GitHubLHAn/Phase_Detection_Project/Master_box_26.07.14/Master_Hình ảnh/Master 04.bmp

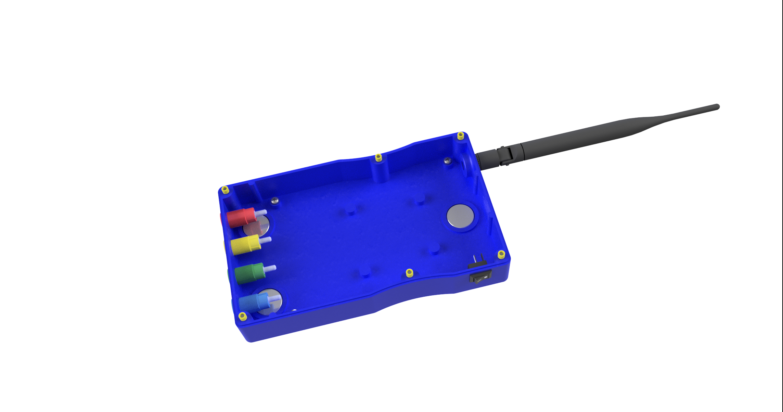
Master_box_26.07.14/Master_Hình ảnh/Master 04.bmp
