GitHubLHAn/Phase_Detection_Project/Master_box_26.07.14/Master_Hình ảnh/Screenshot_1.png

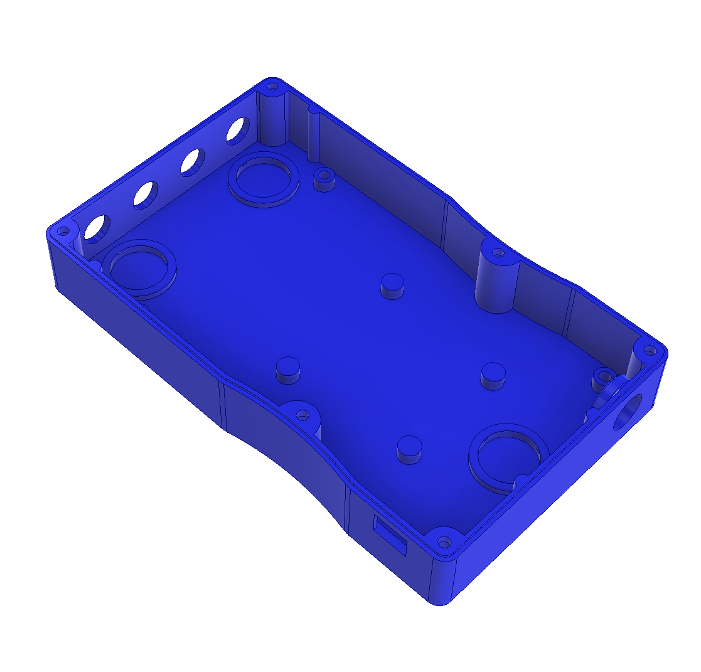
Master_box_26.07.14/Master_Hình ảnh/Screenshot_1.png
