GitHubLHAn/Phase_Detection_Project/master_image.png

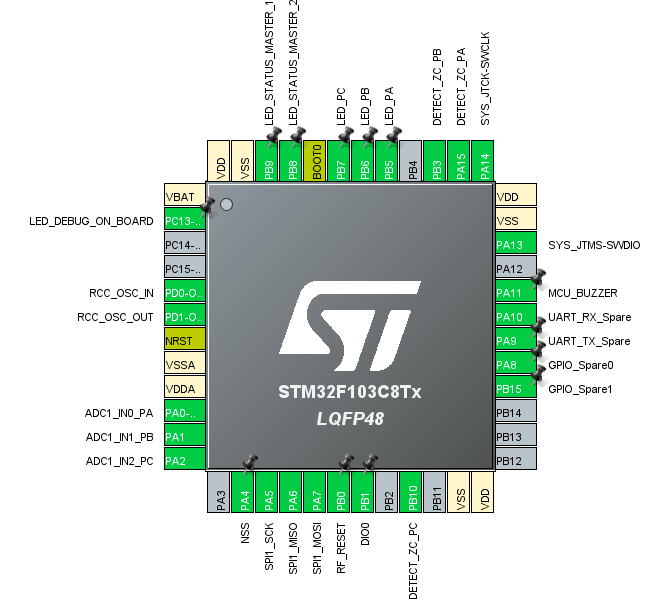
master_image.png
