GitHubLHAn/Phase_Detection_Project/Slave_box_26.07.14/Hình ảnh/Screenshot_6.png

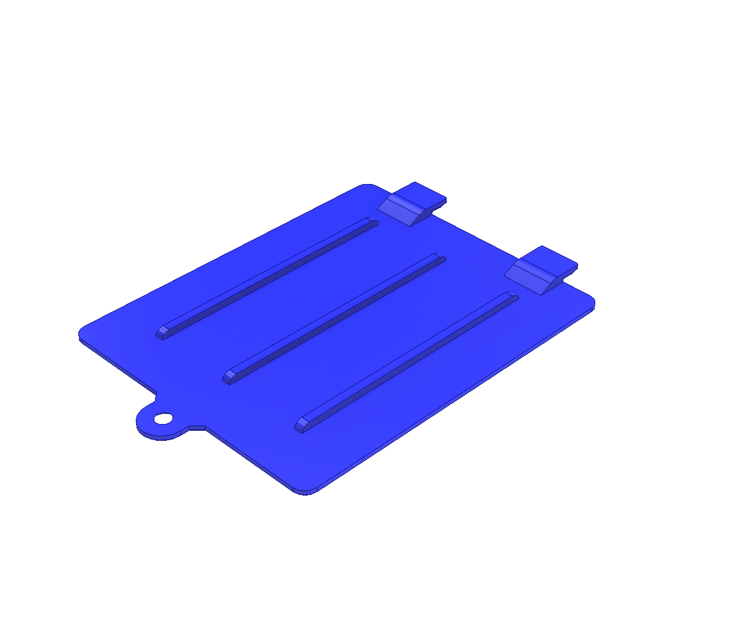
Slave_box_26.07.14/Hình ảnh/Screenshot_6.png
