GitHubLHAn/Phase_Detection_Project/Slave_box_26.07.14/Hình ảnh/Slave-02.bmp

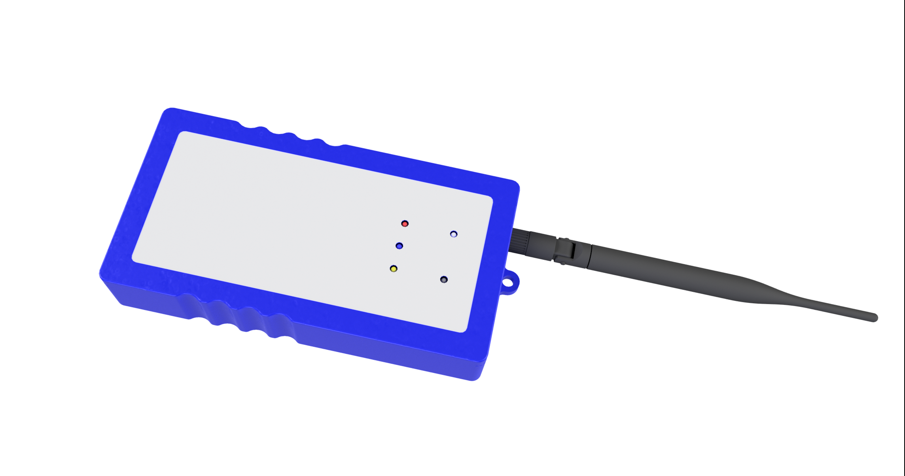
Slave_box_26.07.14/Hình ảnh/Slave-02.bmp
