GitHubLHAn/Phase_Detection_Project/Master_box_26.07.14/3D Step/Nắp Master_SLA_Màu xanh Cô ban_SL01.stp

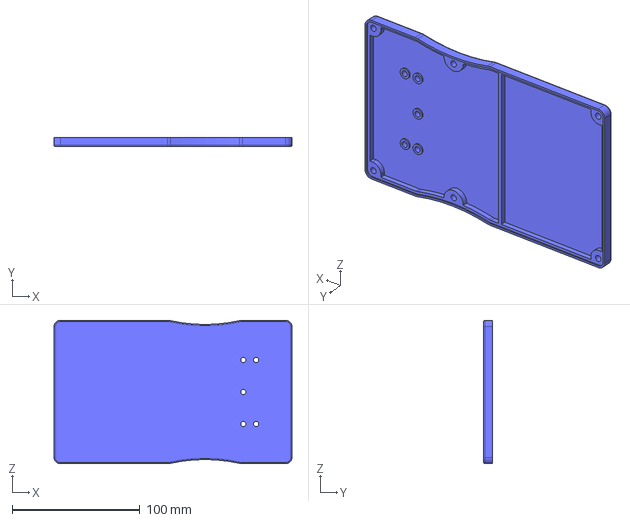
[picture p16: CAD file, 2026-07-15]
Master_box_26.07.14/3D Step/Nắp Master_SLA_Màu xanh Cô ban_SL01.stp
186.0 x 7.00 x 112.0 mm
