GitHubLHAn/Phase_Detection_Project/Master_box_26.07.14/In 3D Master_26.07.14/Hộp Master.stl

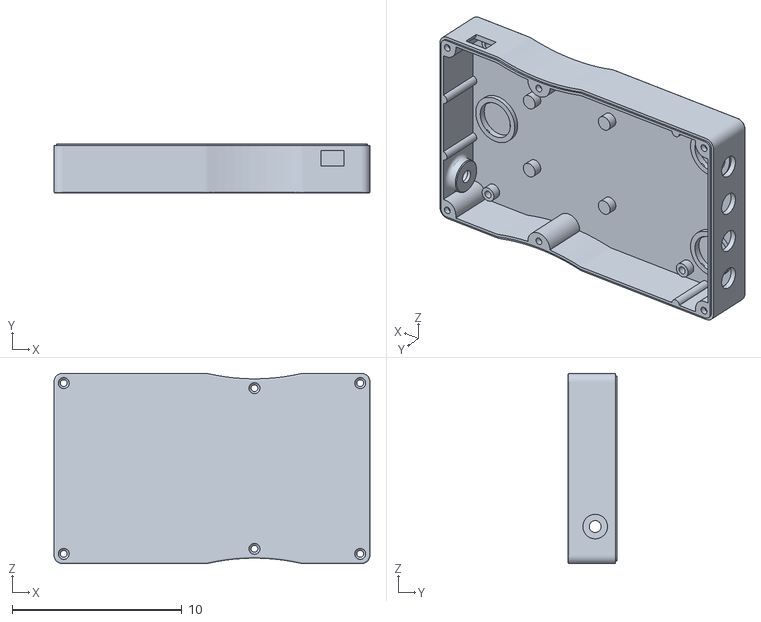
[picture p17: CAD file, 2026-07-15]
Master_box_26.07.14/In 3D Master_26.07.14/Hộp Master.stl
18.6 x 2.90 x 11.2
