GitHubLHAn/Phase_Detection_Project/Slave_box_26.07.14/3D Step/Nắp Slave_SLA_Màu Xanh Cô Ban_SL01.stp

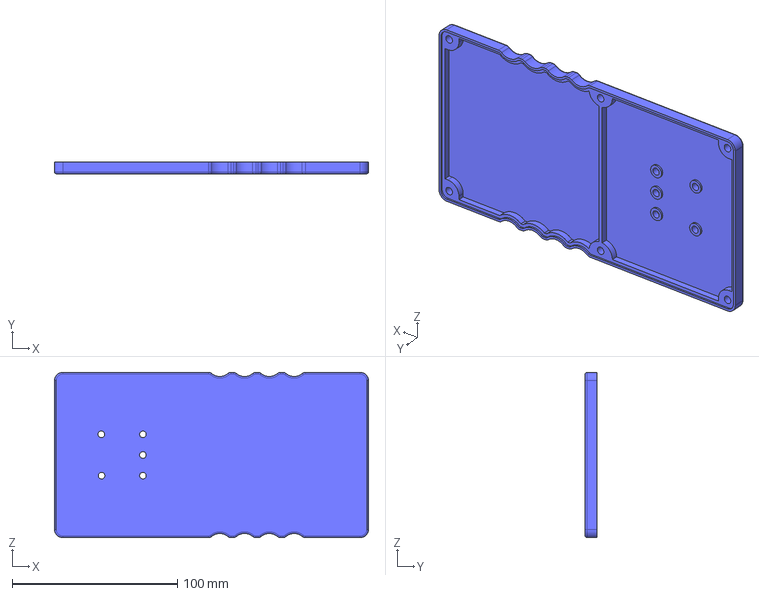
[picture p18: CAD file, 2026-07-15]
Slave_box_26.07.14/3D Step/Nắp Slave_SLA_Màu Xanh Cô Ban_SL01.stp
190.0 x 7.00 x 100.0 mm
