GitHubLHAn/Phase_Detection_Project/Slave_box_26.07.14/In 3D Slave_26.07.14/Nắp Slave.stl

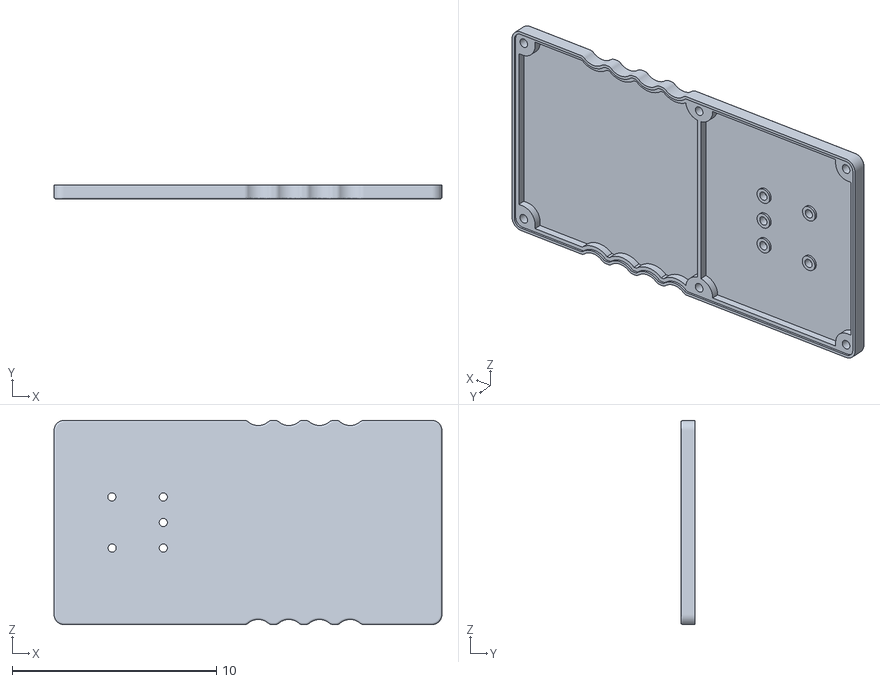
[picture p19: CAD file, 2026-07-15]
Slave_box_26.07.14/In 3D Slave_26.07.14/Nắp Slave.stl
19.0 x 0.7 x 10.0
