GitHubLHAn/Phase_Detection_Project/Master_box_26.07.14/In 3D Master_26.07.14/Nắp Master.stl

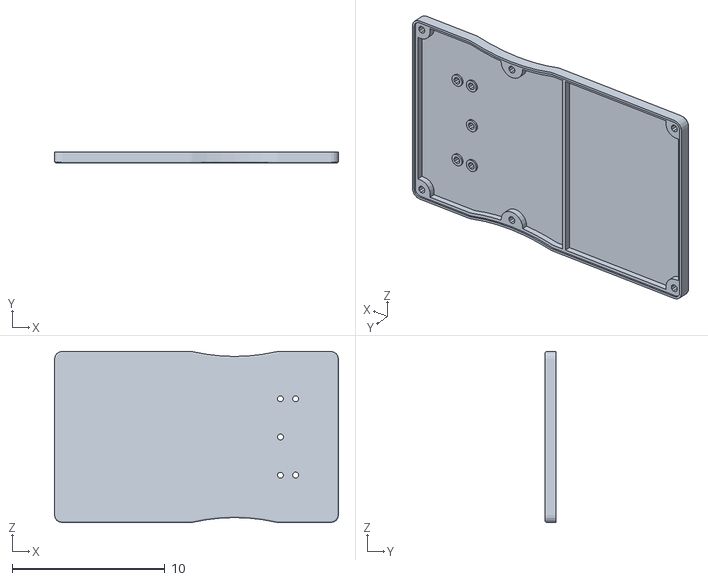
[picture p21: CAD file, 2026-07-15]
Master_box_26.07.14/In 3D Master_26.07.14/Nắp Master.stl
18.6 x 0.7 x 11.2
