GitHubLHAn/Phase_Detection_Project/Slave_box_26.07.14/3D Step/Hộp Slave_SLA_Màu Xanh Cô Ban_SL01.stp

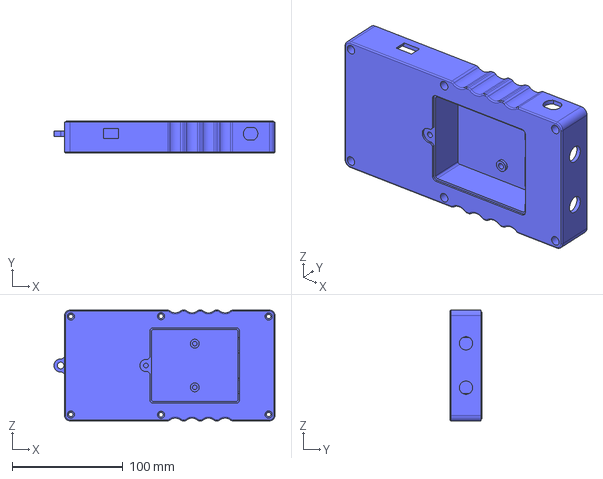
[picture p22: CAD file, 2026-07-15]
Slave_box_26.07.14/3D Step/Hộp Slave_SLA_Màu Xanh Cô Ban_SL01.stp
199.5 x 29.0 x 100.0 mm
