GitHubLHAn/Phase_Detection_Project/Slave_box_26.07.14/In 3D Slave_26.07.14/Hộp Slave.stl

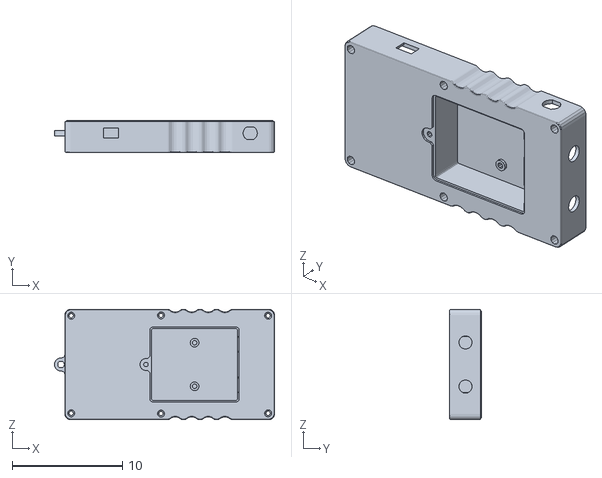
[picture p23: CAD file, 2026-07-15]
Slave_box_26.07.14/In 3D Slave_26.07.14/Hộp Slave.stl
19.9 x 2.90 x 10.0
