GitHubLHAn/Phase_Detection_Project/Slave_box_26.07.14/3D Step/Cover pin_SLA_Màu Xanh Cô Ban_SL01.stp

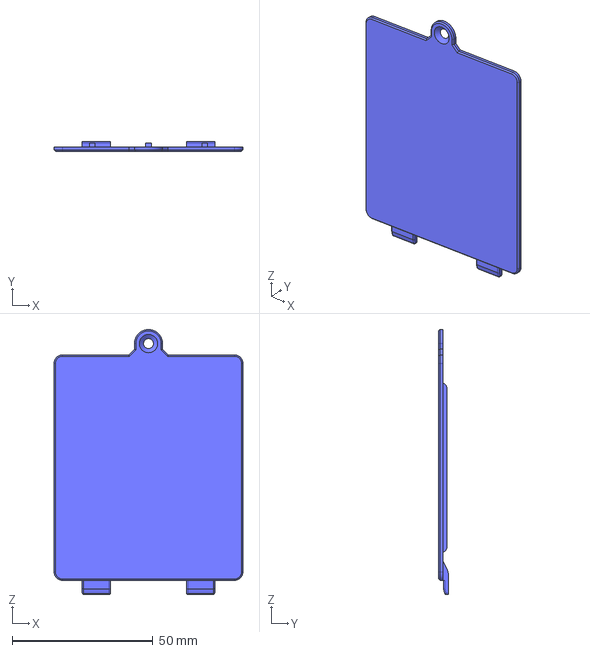
[picture p24: CAD file, 2026-07-15]
Slave_box_26.07.14/3D Step/Cover pin_SLA_Màu Xanh Cô Ban_SL01.stp
67.0 x 3.50 x 94.0 mm
