GitHubLHAn/Phase_Detection_Project/Slave_box_26.07.14/In 3D Slave_26.07.14/Cover pin.stl

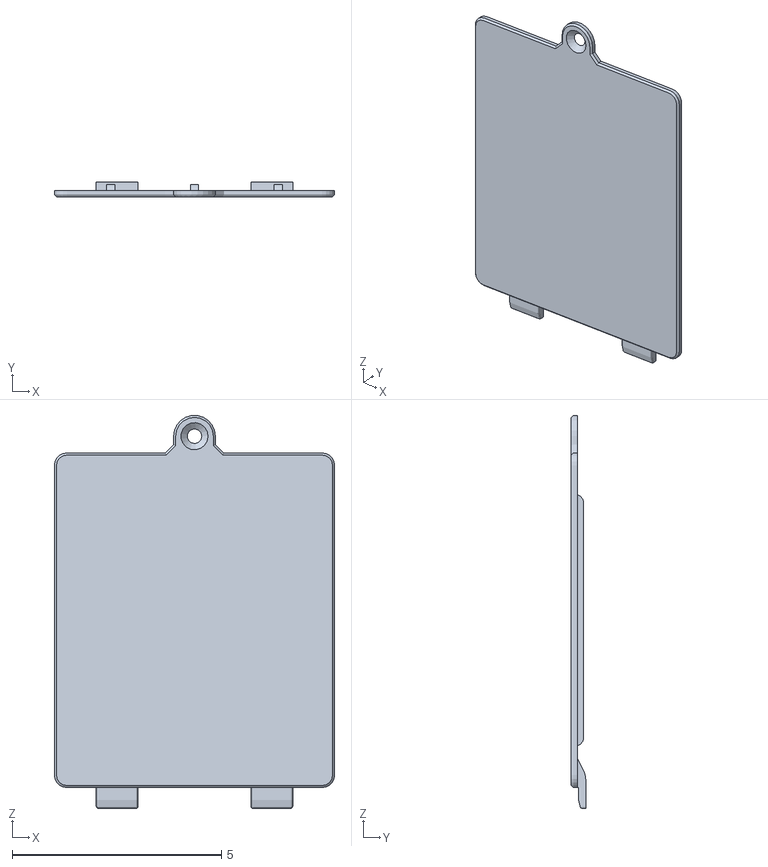
[picture p25: CAD file, 2026-07-15]
Slave_box_26.07.14/In 3D Slave_26.07.14/Cover pin.stl
6.70 x 0.35 x 9.39
