GitHubLHAn/Phase_Detection_Project/(list of files, cad)

Other CAD files:
Master_box_26.07.14/2D/Master.dwg
Slave_box_26.07.14/2D/Slave.dwg
Slave_box_26.07.14/2D/OldVersions/Slave.0001.dwg
