GitHubLHAn/Phase_Detection_Project/MASTER_v1.pdf

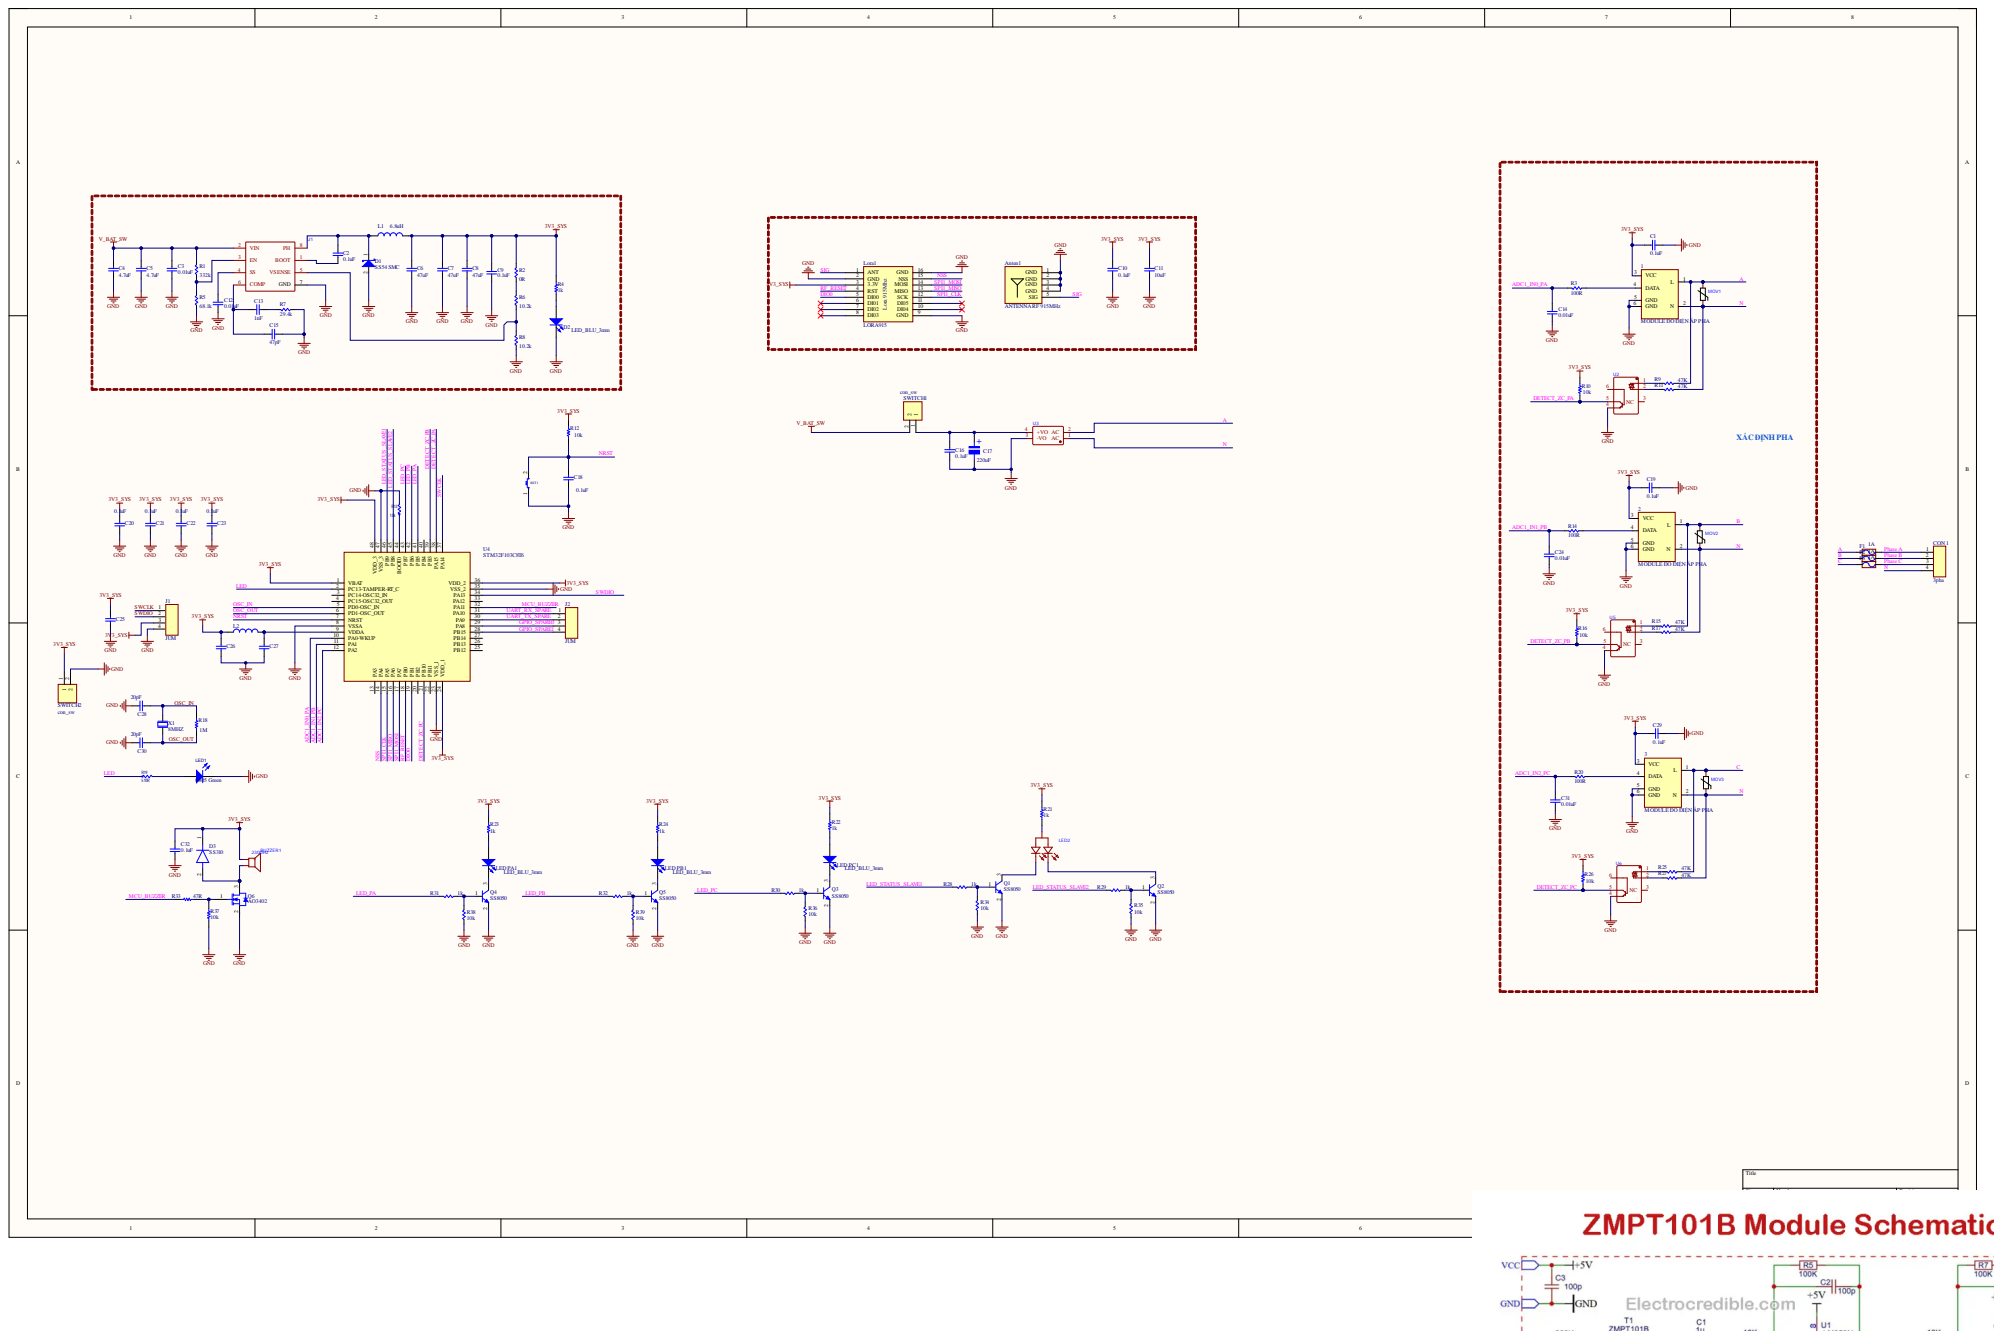
[picture p26: page 1]

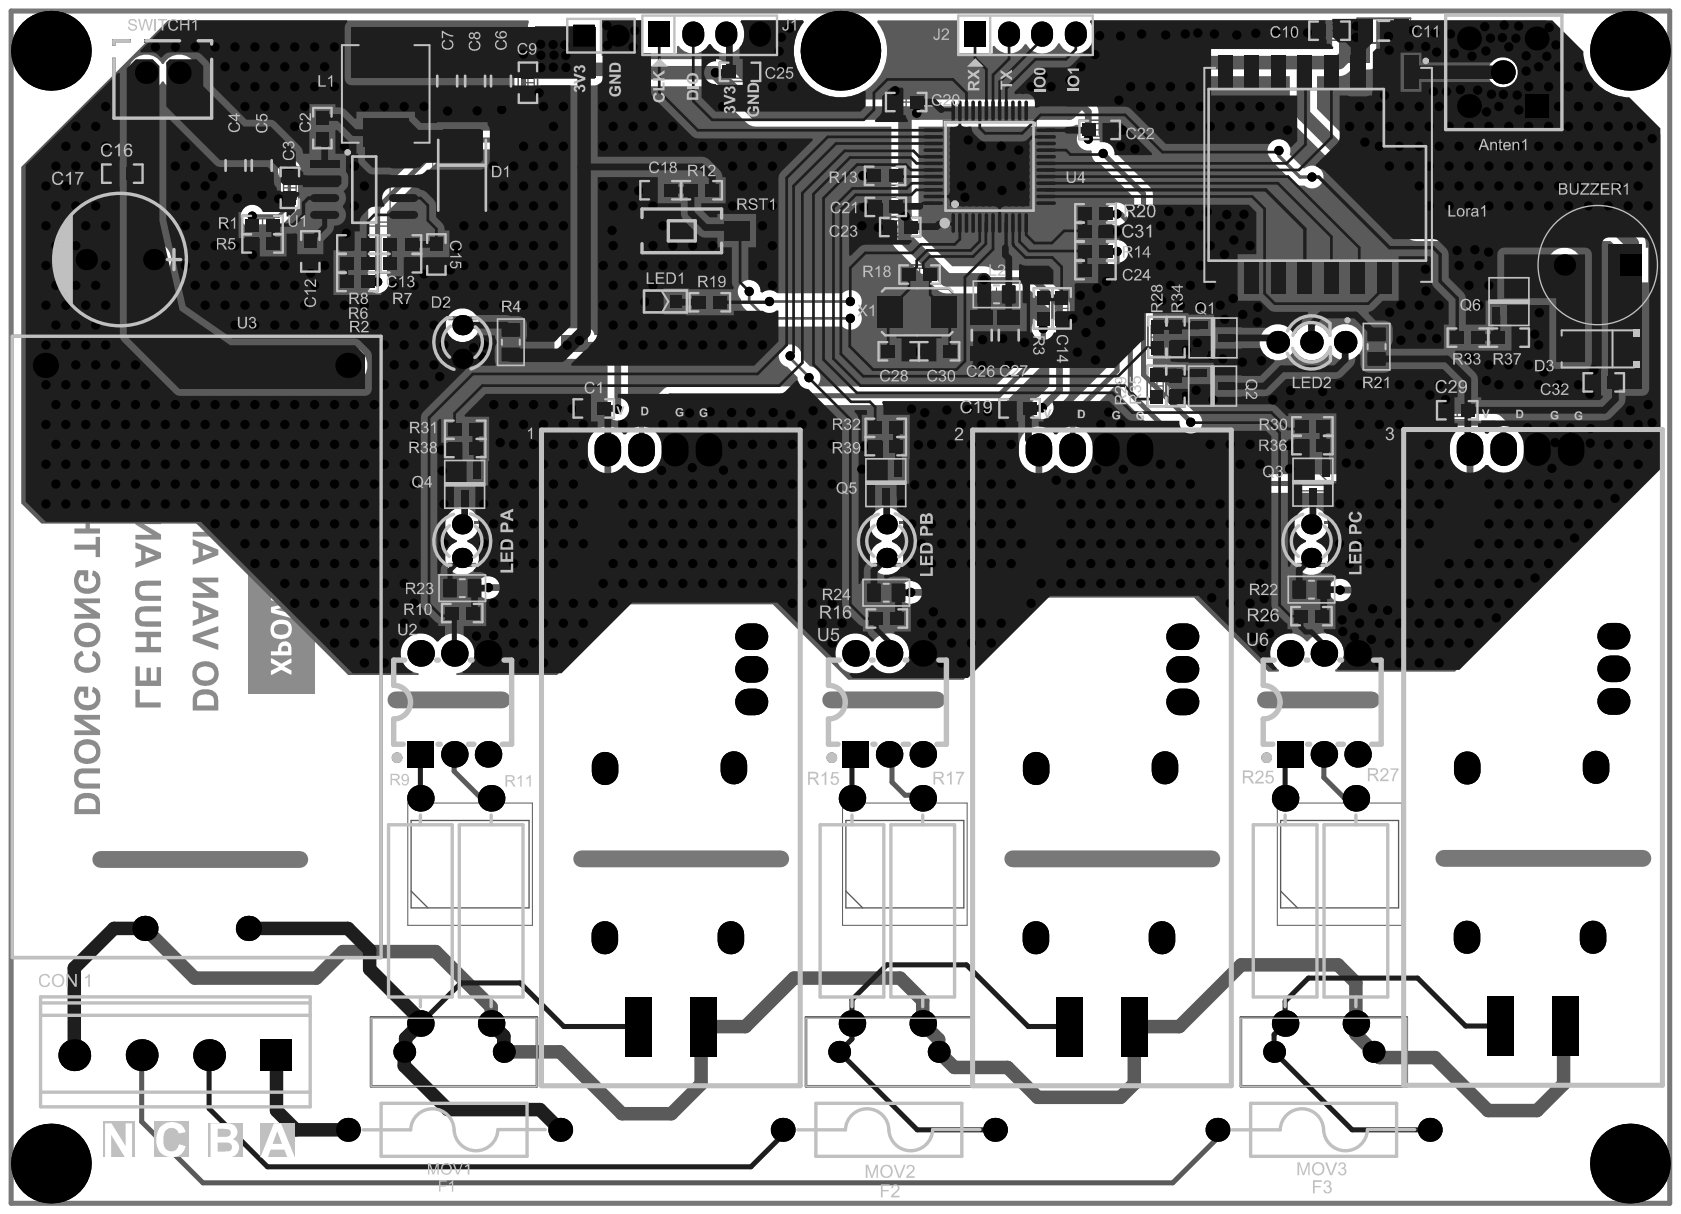
[picture p27: page 2]

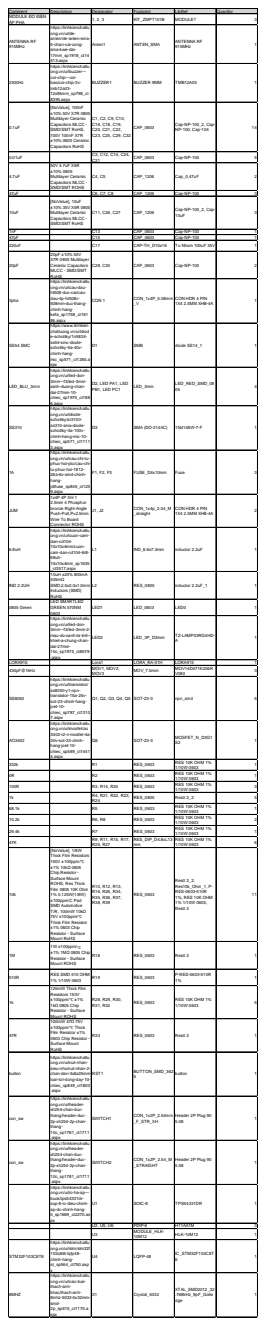
[picture p28: page 3]

ANTENNA RF 915MHz | https://linhkienchatluong.vn/urlde-anten/de-anten-sma-5-chan-cai-cong-sma-kwe-dai-17mm_sp1918_ct14 413.aspx | Anten1 | ANTEN_SMA | ANTENNA RF 915MHz | | 1

2300Hz | https://linhkienchatluong.vn/urlbuzzer---coi-chip---coi-bao/coi-chip-3v-tmb12a03-12x95mm_sp798_ct 8395.aspx | BUZZER1 | BUZZER 9MM | TMB12A03 | | 1

0.1uF | [NoValue], 100nF ±10% 50V X7R 0805 Multilayer Ceramic Capacitors MLCC -SMD/SMT RoHS, 100V 100nF X7R ±10% 0603 Ceramic Capacitors RoHS | C1, C2, C9, C10, C16, C18, C19, C20, C21, C22, C23, C25, C29, C32 | CAP_0603 | Cap-NP-100_2, Cap-NP-100, Cap-104 | 14

0.01uF | | C3, C12, C14, C24, C31 | CAP_0603 | Cap-NP-100 | | 5

4.7uF | 50V 4.7uF X5R ±10% 0805 Multilayer Ceramic Capacitors MLCC -SMD/SMT ROHS | C4, C5 | CAP_1206 | Cap_0.47uF | | 2

47uF | | C6, C7, C8 | CAP_1206 | Cap-NP-100 | | 3

10uF | [NoValue], 10uF ±10% 35V X5R 0805 Multilayer Ceramic Capacitors MLCC -SMD/SMT RoHS | C11, C26, C27 | CAP_1206 | Cap-NP-100_2, Cap-10uF | | 3

1nF 47pF 220uF | C13 C15 C17 | CAP_0603 CAP_0603 CAP-TH_D10x16 | Cap-NP-100 Cap-NP-100 Tu Nhom 100uF 35V | 1 1 1

20pF | 20pF ±10% 50V X7R 0805 Multilayer Ceramic Capacitors MLCC - SMD/SMT RoHS | C28, C30 | CAP_0603 | Cap-NP-100 | 2

3pha | https://linhkienchatluong.vn/urlcau-dau-ht508-duc-cai/cau-dau-4p-ht508v-508mm-duc-thang-chinh-hang-kefa_sp1758_ct161 86.aspx | CON 1 | CON_1x4P_5.08mm _V | CON HDR 4 PIN 1X4 2.5MM XHB-4A | 1

SS54 SMC | https://www.linhkienchatluong.vn/urldiode-schottky/1n5824-ss54-smc-diode-schottky-5a-40v-chinh-hang-mic_sp571_ct1265.a spx | D1 | SMB | diode SS14_1 | 1

LED_BLU_3mm | https://linhkienchatluong.vn/urlled-don-3mm---f3/led-3mm-xanh-duong-chan-dai-27mm-10-chiec_sp1975_ct188 6.aspx | D2, LED PA1, LED PB1, LED PC1 | LED_3mm | LED_RED_SMD_08 05 | 4

SS310 | https://linhkienchatluong.vn/urldiode-schottky/sr3100-ss310-sma-diode-schottky-3a-100v-chinh-hang-mic-10-chiec_sp571_ct1111 3.aspx | D3 | SMA (DO-214AC) | 1N4148W-7-F | 1

1A | https://linhkienchatluong.vn/urlcau-chi-tu-phuc-hoi-ptc/cau-chi-tu-phuc-hoi-1812-26a-6v-smd-chinh-hang-jdtfuse_sp845_ct125 9.aspx | F1, F2, F3 | FUSE_D4x10mm | Fuse | 3

JUM | 1x4P 4P XH 1 2.5mm 4 Phosphor bronze Right-Angle Push-Pull,P=2.5mm Wire To Board Connector ROHS | J1, J2 | CON_1x4p_2.54_M _straight | CON HDR 4 PIN 1X4 2.5MM XHB-4A | 2

6.8uH | https://linhkienchatluong.vn/urlcuon-cam-dan-cd104-10x10x4mm/cuon-cam-dan-cd104-6r8-68uh-10x10x4mm_sp1635_ct3517.aspx | L1 | IND_6.6x7.3mm | inductor 2.2uF | 1

IND 2.2UH | 10uH ±20% 800mA 435mΩ SMD,2.5x2.0x1.0mm Inductors (SMD) RoHS | L2 | RES_0805 | inductor 2.2uF_1 | 1

0805 Green | LED SMARTLED GREEN 570NM 0603 | LED1 | LED_0603 | LED0 | 1

https://linhkienchatluong.vn/urlled-don-3mm---f3/led-3mm-2-mau-do-xanh-la-tinh-khiet-a-chung-chan-dai-27mm-10c_sp1975_ct8579 .aspx | LED2 | LED_3P_D3mm | TZ-LAMP03RG4HD-A | 1

LORA915 430pF@1kHz | | Lora1 MOV1, MOV2, MOV3 | LORA_RA-01H MOV_7.5mm | LORA915 MOV14D471K206R V080 | 1 3

SS8050 | https://linhkienchatluong.vn/urltransistor/ss8050-y1-npn-transistor-15a-25v-sot-23-chinh-hang-jcet-10-chiec_sp787_ct1310 7.aspx | Q1, Q2, Q3, Q4, Q5 | SOT-23-3 | npn_smd | | 5

AO3402 | https://linhkienchatluong.vn/urlmosfet/ao 3402-r2-n-mosfet-4a-30v-sot-23-chinh-hang-jcet-10-chiec_sp589_ct1441 4.aspx | Q6 | SOT-23-3 | MOSFET_N_D3G1 S2 | | 1

332k | | R1 | RES_0603 | RES 10K OHM 1% 1/10W 0603 | | 1

0R | | R2 | RES_0603 | RES 10K OHM 1% 1/10W 0603 | | 1

100R | | R3, R14, R20 | RES_0603 | RES 10K OHM 1% 1/10W 0603 | | 3

1k | | R4, R21, R22, R23, R24 | RES_0805 | Res0.3_2 | | 5

68.1k | | R5 | RES_0603 | RES 10K OHM 1% 1/10W 0603 | | 1

10.2k | | R6, R8 | RES_0603 | RES 10K OHM 1% 1/10W 0603 | | 2

29.4k | | R7 | RES_0603 | RES 10K OHM 1% 1/10W 0603 | | 1

47K | | R9, R11, R15, R17, R25, R27 | RES_DIP_D4.8xL13 mm | RES 10K OHM 1% 1/10W 0603 | | 6

10k | [NoValue], 1/8W Thick Film Resistors 150V ±100ppm/℃ ±1% 10kΩ 0805 Chip Resistor -Surface Mount ROHS, Res Thick Film 0805 10K Ohm 1% 0.125W(1/8W) ±100ppm/C Pad SMD Automotive T/R, 100mW 10kΩ 75V ±100ppm/℃ Thick Film Resistor ±1% 0603 Chip Resistor - Surface Mount RoHS | R10, R12, R13, R16, R26, R34, R35, R36, R37, R38, R39 | RES_0603 | Res0.3_2, Res10k_Ohm_1, P-RES-0603-510R 1%, RES 10K OHM 1% 1/10W 0603, Res0.3 | 11

1M | 1W ±100ppm/℃ ±1% 1MΩ 0805 Chip Resistor - Surface Mount ROHS | R18 | RES_0603 | Res0.3 | | 1

510R | RES SMD 510 OHM 1% 1/10W 0603 | R19 | RES_0603 | P-RES-0603-510R 1% | | 1

1k | 125mW Thick Film Resistors 150V ±100ppm/℃ ±1% 1kΩ 0805 Chip Resistor - Surface Mount ROHS | R28, R29, R30, R31, R32 | RES_0603 | RES 10K OHM 1% 1/10W 0603 | | 5

47R | 100mW 47Ω 75V ±100ppm/℃ Thick Film Resistor ±1% 0603 Chip Resistor -Surface Mount RoHS | R33 | RES_0603 | Res0.3 | | 1

button | https://linhkienchatluong.vn/urlnut-nhan-sieu-nho/nut-nhan-2-chan-dan-3x6x25mm-loai-tot-dong-day-10-chiec_sp849_ct1800 .aspx | RST1 | BUTTON_SMD_362 5 | button | | 1

con_sw | https://linhkienchatluong.vn/urlheader-xh254-chan-duc-thang/header-duc-2p-xh254-2p-chan-thang-10c_sp1781_ct1711 .aspx | SWITCH1 | CON_1x2P_2.54mm _F_STR_XH | Header 2P Plug 90 5.08 | | 1

con_sw | https://linhkienchatluong.vn/urlheader-xh254-chan-duc-thang/header-duc-2p-xh254-2p-chan-thang-10c_sp1781_ct1711 .aspx | SWITCH2 | CON_1x2P_2.54_M _STRAIGHT | Header 2P Plug 90 5.08 | | 1

https://linhkienchatluong.vn/urlic-ha-ap---buck/tps54331dr-sop-8-ic-dieu-chinh-ap-dc-chinh-hang-ti_sp1669_ct2270.as px | U1 | SOIC-8 | TPS54331DR | | 1

U2, U5, U6 U3 | PDIP-6 MODULE_HLK-10M12 | H11AA1M HLK-10M12 | | 3 1

STM32F103C8T6 | https://linhkienchatluong.vn/urlstm/stm32f 103c8t6-lqfp48-chinh-hang-st_sp564_ct750.asp x | U4 | LQFP-48 | IC_STM32F103C8T 6 | 1

8MHZ | https://linhkienchatluong.vn/urlcac-loai-thach-anh-khac/thach-anh-8mhz-5032-5x32mm-smd-2p_sp615_ct1170.a spx | X1 | Crystal_5032 | XTAL_SMD2012_32 .768kHz_9pF_Golle dge | 1
