GitHubLHAn/Phase_Detection_Project/SLAVE_v1.pdf

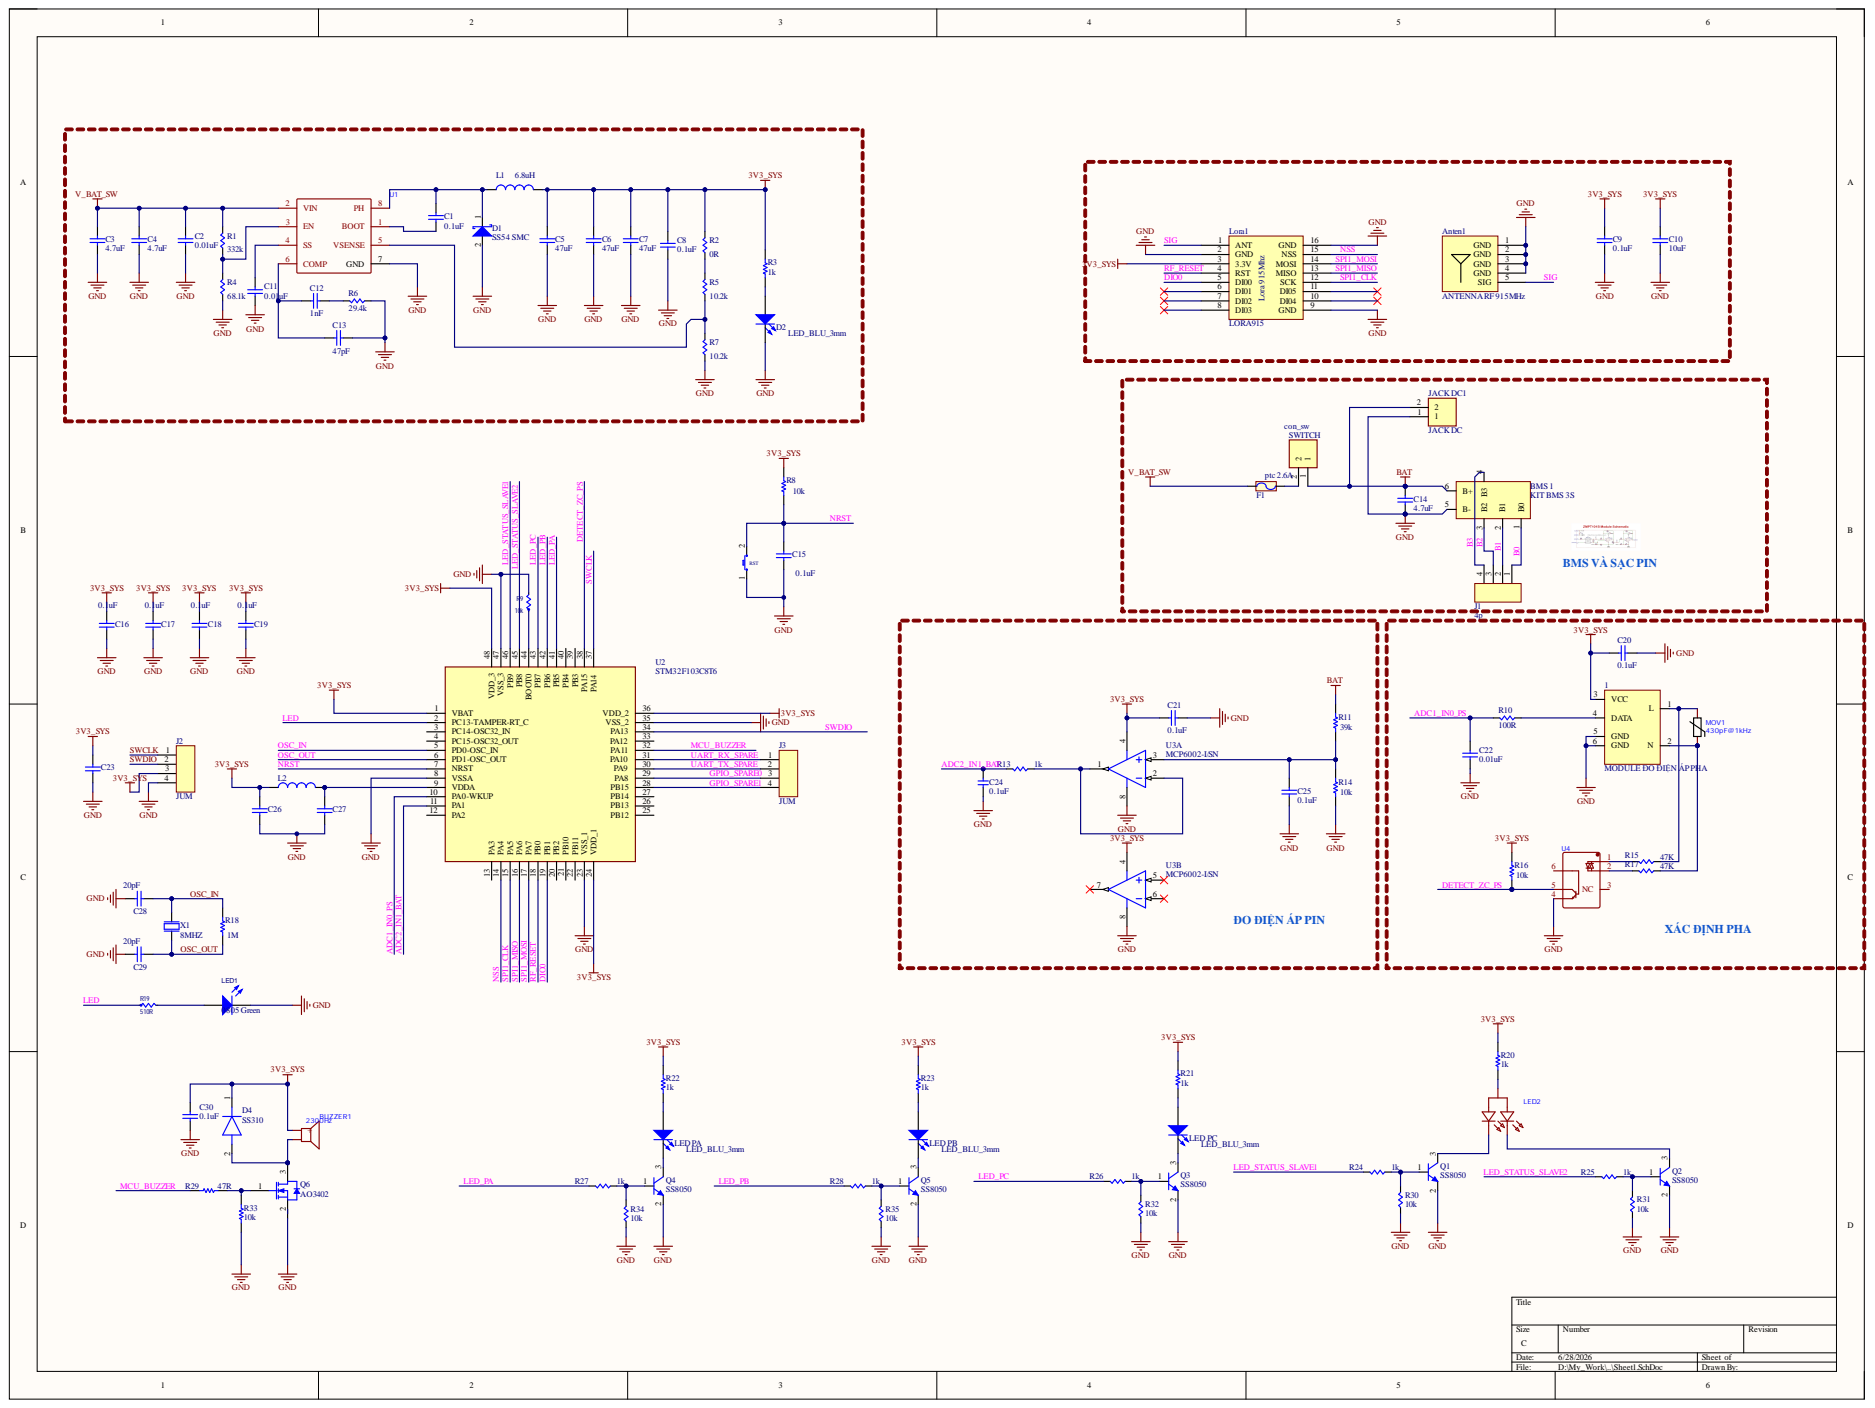
[picture p29: page 1]

BMS VÀ SẠC PIN

MODULE ĐO ĐIỆN ÁPPHA

PA0-WKUP 10

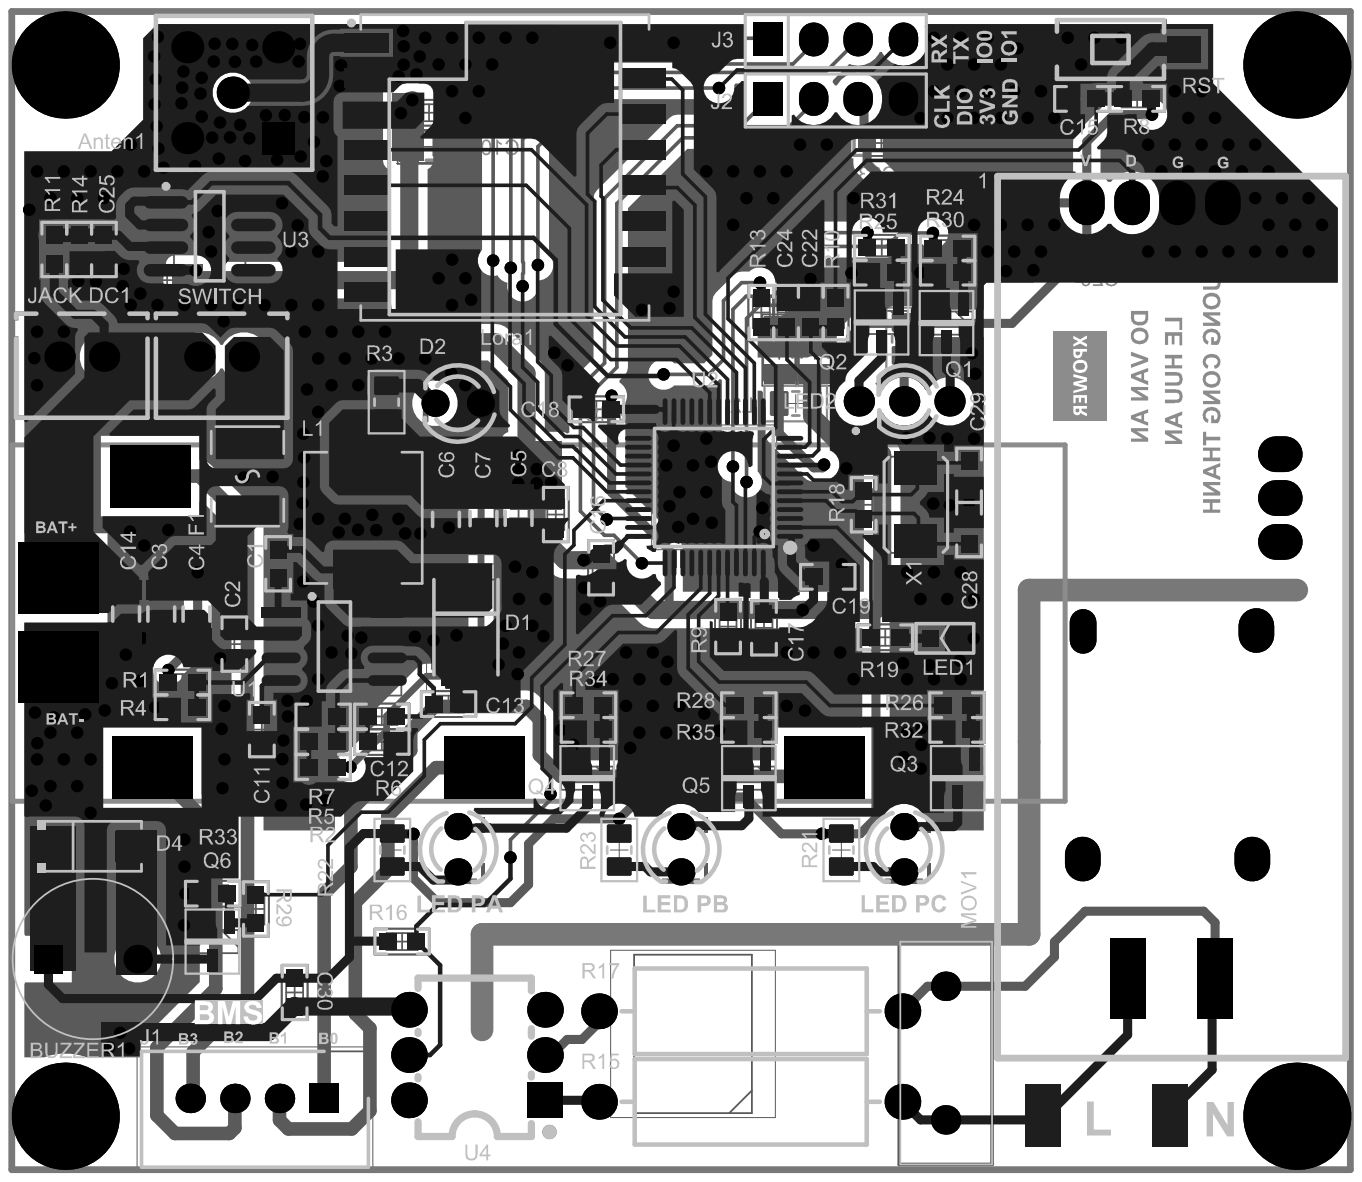
[picture p30: page 2]
