GitHubLHAn/Phase_Detection_Project/Master_box_26.07.14/Master_Hình ảnh/Master.pdf

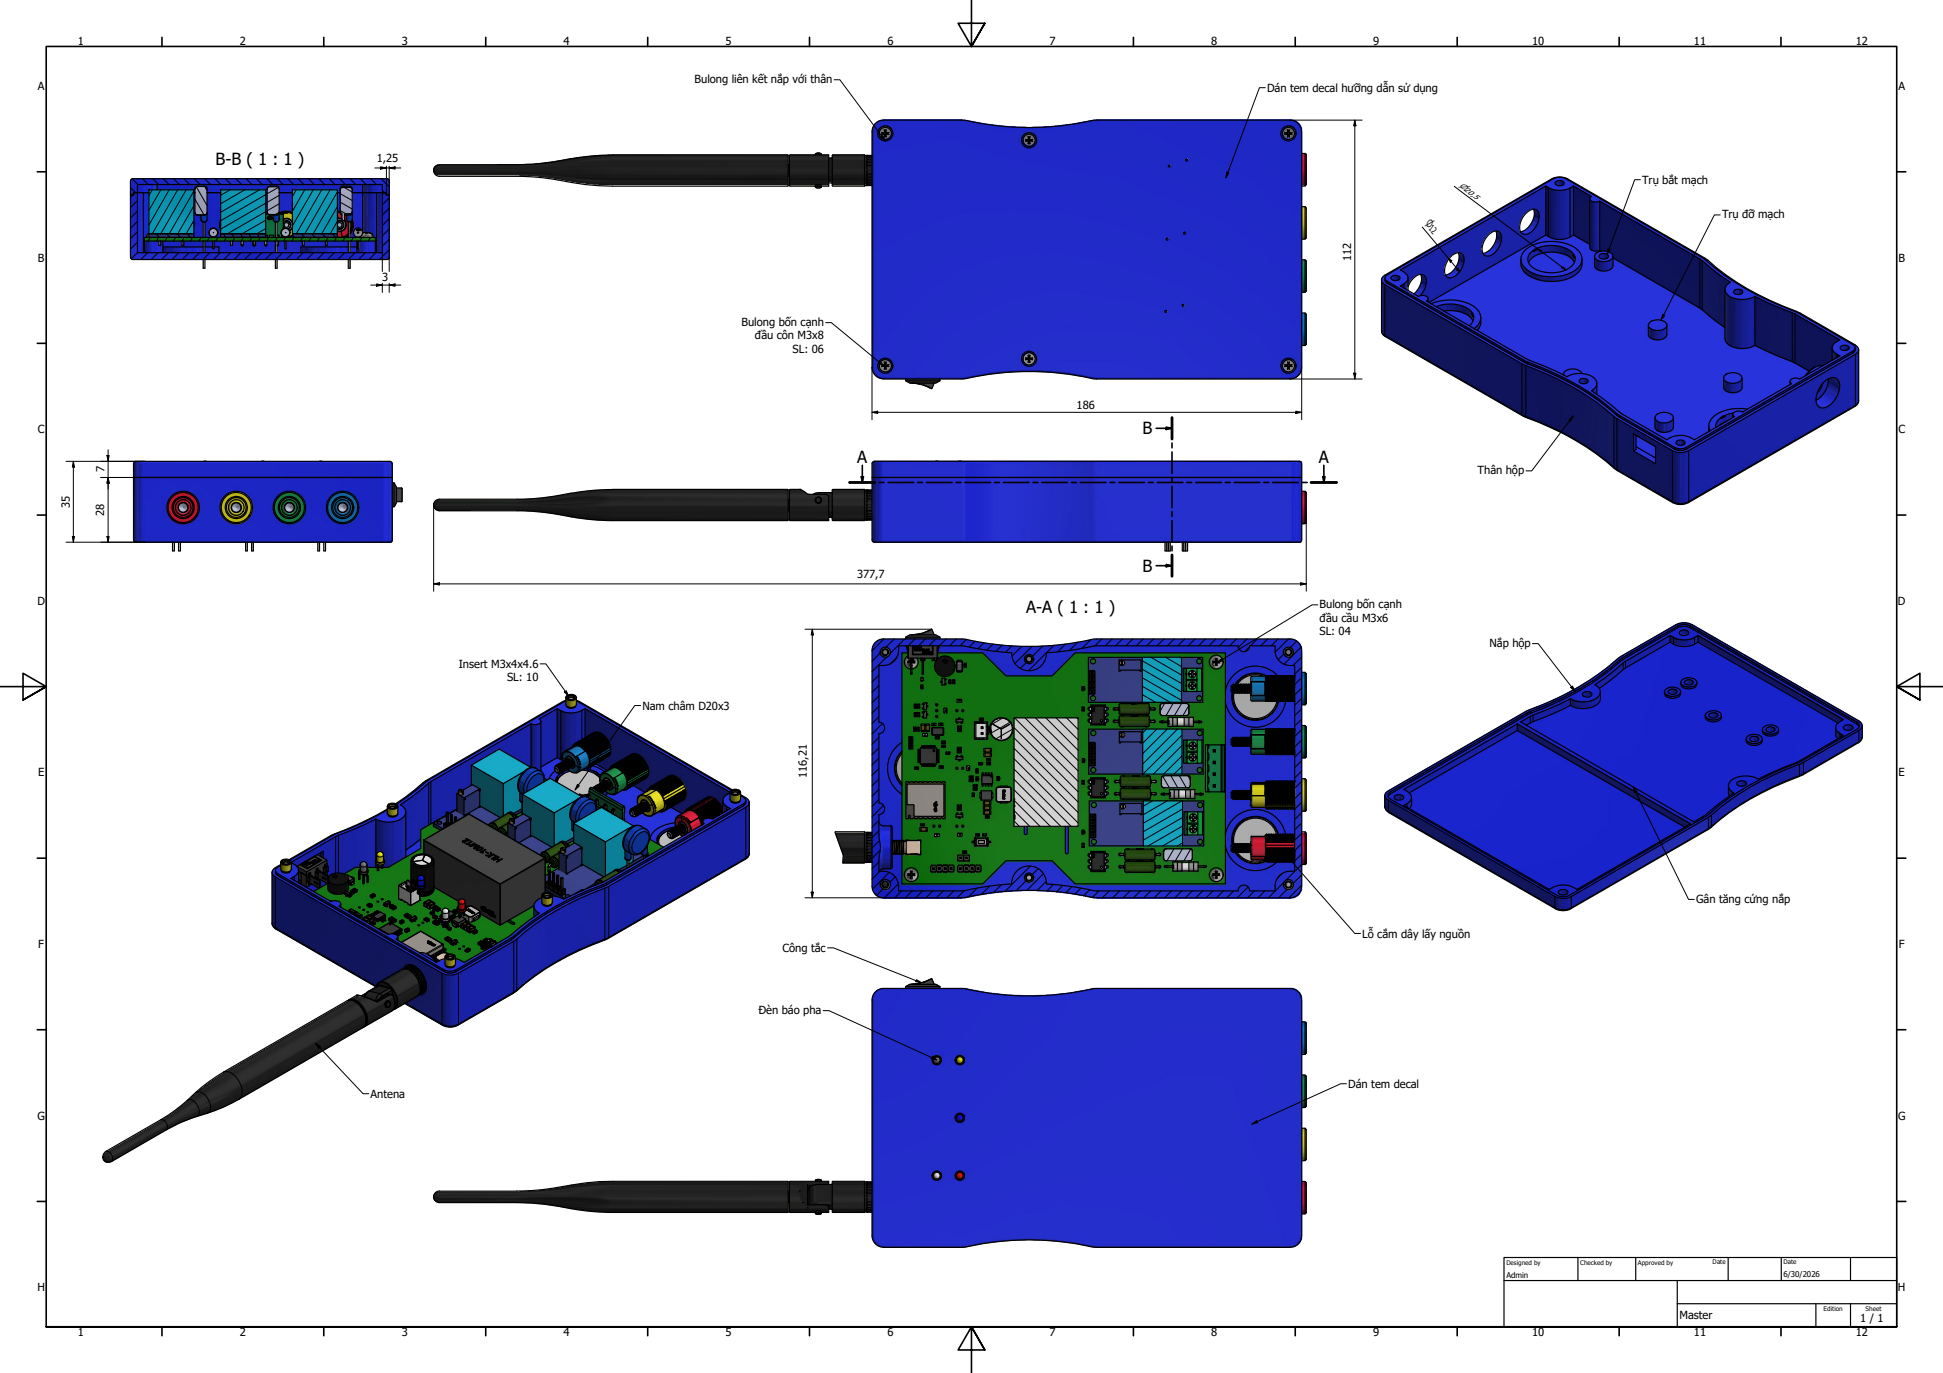
[picture p31: page 1]
Designed by; Checked by; Approved by; Date; Nam chkm D20x3; Insert M3x4x4.6 SL: 10

Bulong lirn kt np vi thkn

Din tem decal hng dn s dng

Gkn tng cng np

qn bio pha

Din tem decal
