GitHubLHAn/Phase_Detection_Project/Slave_box_26.07.14/Hình ảnh/Slave.pdf

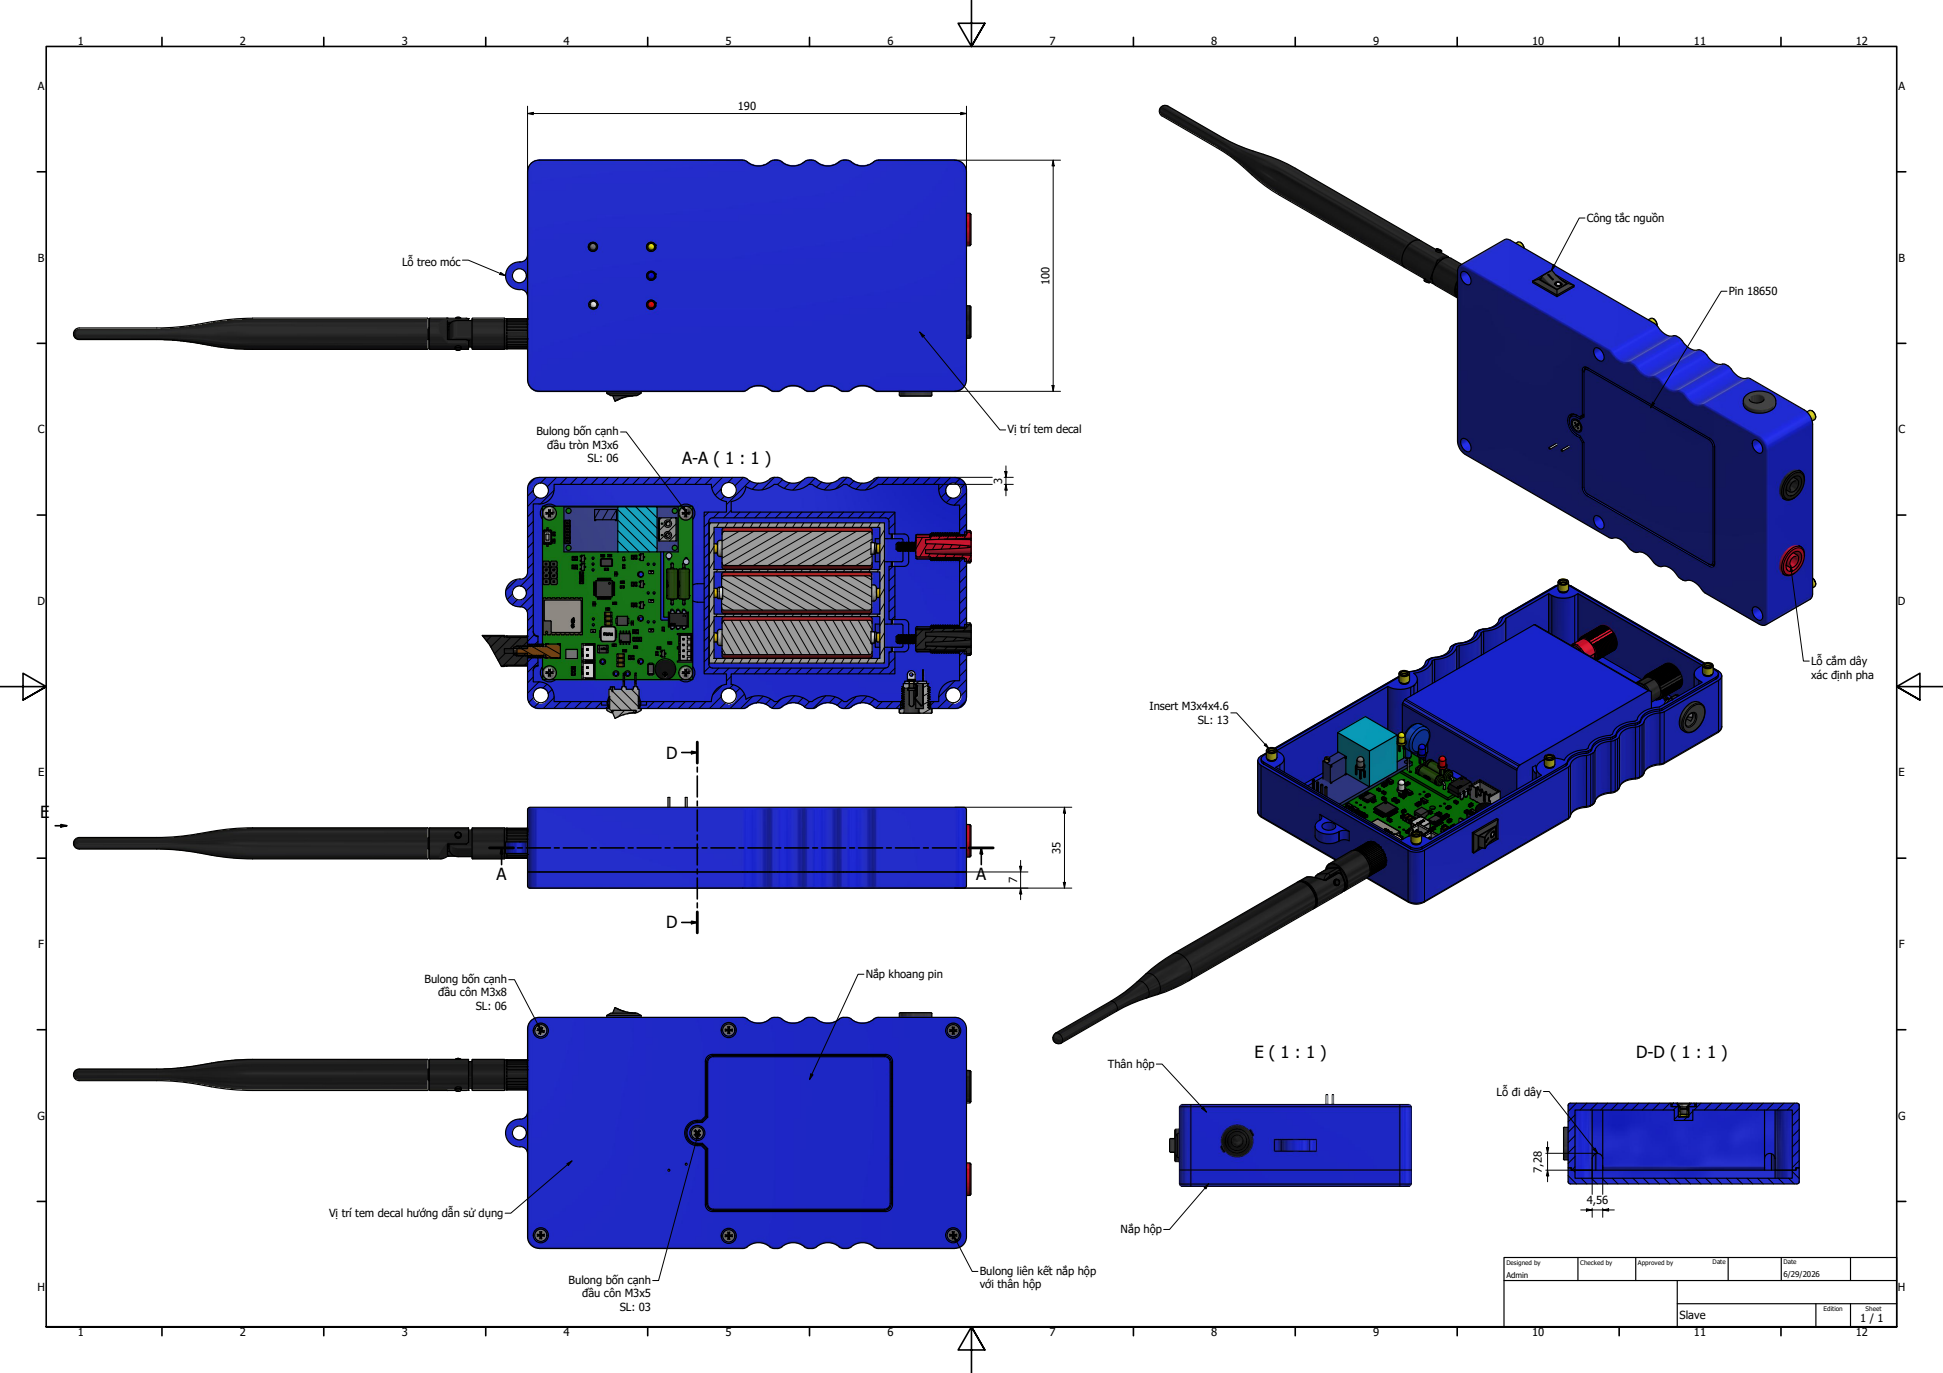
[picture p32: page 1]
Designed by; Checked by; Approved by; Date; Pin 18650; Insert M3x4x4.6 SL: 13

V trt tem decal

L cm dky
xic ÿnh pha

V trt tem decal hng dn s dng
