GitHubLHAn/Phase_Detection_Project/Master_Sender_v1/Core/Src/main.c

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
/* Includes ------------------------------------------------------------------*/
#include "main.h"

/* USER CODE BEGIN Includes */

#include "LoRa.h"
#include <string.h>

#include <stdio.h>
#include <stdbool.h>

/* USER CODE END Includes */

/* USER CODE BEGIN PD */

#define ON_LED_DEBUG( )	HAL_GPIO_WritePin(LED_DEBUG_ON_BOARD_GPIO_Port, LED_DEBUG_ON_BOARD_Pin, GPIO_PIN_SET)
#define OFF_LED_DEBUG( )	HAL_GPIO_WritePin(LED_DEBUG_ON_BOARD_GPIO_Port, LED_DEBUG_ON_BOARD_Pin, GPIO_PIN_RESET)
#define TOGGLE_LED_DEBUG( )	HAL_GPIO_TogglePin(LED_DEBUG_ON_BOARD_GPIO_Port, LED_DEBUG_ON_BOARD_Pin)

#define ON_LED_PA( )	HAL_GPIO_WritePin(LED_PA_GPIO_Port, LED_PA_Pin, GPIO_PIN_SET);
#define OFF_LED_PA( )	HAL_GPIO_WritePin(LED_PA_GPIO_Port, LED_PA_Pin, GPIO_PIN_RESET);

#define ON_LED_PB( )	HAL_GPIO_WritePin(LED_PB_GPIO_Port, LED_PB_Pin, GPIO_PIN_SET);
#define OFF_LED_PB( )	HAL_GPIO_WritePin(LED_PB_GPIO_Port, LED_PB_Pin, GPIO_PIN_RESET);

#define ON_LED_PC( )	HAL_GPIO_WritePin(LED_PC_GPIO_Port, LED_PC_Pin, GPIO_PIN_SET);
#define OFF_LED_PC( )	HAL_GPIO_WritePin(LED_PC_GPIO_Port, LED_PC_Pin, GPIO_PIN_RESET);

// Buzzer active
#define BUZZER_ON()  HAL_GPIO_WritePin(MCU_BUZZER_GPIO_Port, MCU_BUZZER_Pin, GPIO_PIN_SET);
#define BUZZER_OFF()  HAL_GPIO_WritePin(MCU_BUZZER_GPIO_Port, MCU_BUZZER_Pin, GPIO_PIN_RESET);



#define MA_SIZE_PHASE_ZC 5

#define ZERO_PA 1984
#define ZERO_PB 1984
#define ZERO_PC 1978

#define CYCLE_GRID 20000

#define RANGE_GRID_L 19750
#define RANGE_GRID_H 20750

#define TIME_DET_PHASE 100   // 2s
#define LOSS_GRID_TIMEOUT 1000   //   100ms/0.1ms = 1000
#define TIME_SEND_CYCLE   2500000   // 2.5s

typedef struct
{
    uint16_t buf[MA_SIZE_PHASE_ZC];
    uint32_t sum;
    uint8_t index;
} MA_Filter_t;

typedef enum
{
  MODE_OFF = 0,
  MODE_STS_1 = 1,
  MODE_STS_2 = 2,

  MODE_SET_FLASH_1 = 3,
  MODE_FLASH_1 = 4,

  MODE_SET_FLASH_2 = 5,
  MODE_FLASH_2 = 6,
}MODE_LED_e;

typedef enum
{
  BUZZER_OFF = 0,
  BUZZER_ON = 1,
  BUZZER_SET_TRIGGER_PIP = 2,
  BUZZER_TRIGGER_PIP = 3,
}MODE_BUZZER_e;

typedef enum
{
  WAIT_NEG = 1,
  WAIT_ZC_UP = 2,
  WAIT_POS = 3,
  LOSS_GRID = 4,
}MODE_DETECT_e;

typedef struct {
    volatile uint16_t* adc_raw_ptr;       // Trỏ tới adc_raw[x]
    MA_Filter_t filter;         // Trỏ tới bộ lọc tương ứng
    uint16_t zero_val;     // Giá trị ZERO_PX
		volatile bool start_detect;
    volatile bool phase_detected;
    volatile uint16_t p_cur;
    volatile uint16_t p_prev;
    volatile uint16_t cnt_detect;
    volatile uint32_t last_zc;
    volatile uint32_t now_zc;
    volatile uint32_t interval_zc;
    volatile bool has_new_edge;          // Cờ báo hiệu có cạnh lên mới cho Main xử lý

    volatile MODE_DETECT_e mode_det;
    volatile uint16_t cnt_det_loss_grid;
  } Phase_Data_t;

/* USER CODE END PD */

ADC_HandleTypeDef hadc1;
DMA_HandleTypeDef hdma_adc1;

SPI_HandleTypeDef hspi1;

TIM_HandleTypeDef htim1;
TIM_HandleTypeDef htim2;
TIM_HandleTypeDef htim3;

UART_HandleTypeDef huart1;
DMA_HandleTypeDef hdma_usart1_tx;

/* USER CODE BEGIN PV */

// Count variables and flags
uint32_t tick_master = 0;
volatile uint32_t cnt_send_cmd = 0;
volatile uint32_t ovf_tim3 = 0;
volatile uint16_t cnt_det_loss_grid = 0;

uint32_t cycle_send = TIME_SEND_CYCLE/50;    

volatile uint8_t flag_cnt_50us = 0;
volatile bool flag_enable_zc = false;

// LED
volatile MODE_LED_e mode_led_status = MODE_OFF;
volatile uint16_t cnt_handle_led = 0;

//BUZZER PASSIVE
volatile MODE_BUZZER_e mode_buzzer_status = BUZZER_OFF;
volatile uint16_t cnt_handle_buzzer = 0;

//LoRa variables
LoRa vLoRa;
uint16_t config_lora = 0xFA;

uint8_t TX_Lora_buff[12];
uint8_t RX_LoRa_buff[12];

uint8_t send_ok = 0;
uint16_t cnt_sendOK = 0;
uint16_t cnt_recOK = 0;
volatile uint16_t num_RX_irq_LoRa = 0;
volatile bool flag_Lora_Rx = false;
volatile bool flag_send_lora = false;

// Phase variables	
Phase_Data_t phaseA, phaseB, phaseC;

volatile uint16_t delta_pAB = 0, delta_pAC = 0;
		
// ADC measurement variables
volatile uint16_t adc_raw[3];

// For calib ADC at zeropoint
uint8_t flag_get_zero = 0;
uint16_t offset_pA = 0;
uint16_t offset_pB = 0;
uint16_t offset_pC = 0;


// For logging
uint32_t stt = 0;
uint8_t flag_tx_log = 0;
uint32_t cnt_log = 0;
char uart_tx_log[100];


// temp variables




/* USER CODE END PV */

void SystemClock_Config(void);
static void MX_GPIO_Init(void);
static void MX_DMA_Init(void);
static void MX_TIM1_Init(void);
static void MX_USART1_UART_Init(void);
static void MX_ADC1_Init(void);
static void MX_SPI1_Init(void);
static void MX_TIM3_Init(void);
static void MX_TIM2_Init(void);
/* USER CODE BEGIN 0 */
void Get_Offset(void);
void Handle_LED(void);
void Handle_Buzzer(void);
void Handle_LoRa_TX(void);
void OFF_LED_STATUS(void);
void ON_LED_STATUS_1(void);
void ON_LED_STATUS_2(void);
void MA_Init(MA_Filter_t *f, uint16_t init_value);
uint16_t MA_Update(MA_Filter_t *f, uint16_t sample);

uint32_t GetTimeUs(){
  uint32_t ovf1, ovf2;
  uint32_t cnt;

  do {
    ovf1 = ovf_tim3;
    cnt = TIM3->CNT;
    ovf2 = ovf_tim3;
  } while (ovf1 != ovf2); // Guard against rollover during reading

  return (ovf1 << 16) + cnt;
}

void Phase_init(Phase_Data_t* p_data, volatile  uint16_t* adc_raw_ptr, uint16_t zero_val){
    p_data->adc_raw_ptr = adc_raw_ptr;
    p_data->zero_val = zero_val;
		p_data->start_detect = false;
    p_data->p_cur = 0;
    p_data->p_prev = 0;
    p_data->cnt_detect = 0;
    p_data->last_zc = 0;
    p_data->now_zc = 0;
    p_data->interval_zc = 0;
    p_data->phase_detected = false;
    p_data->has_new_edge = false;
    MA_Init(&p_data->filter, zero_val);

    p_data->mode_det = WAIT_NEG;
    p_data->cnt_det_loss_grid = 0;
}

static inline void Process_Phase_ZC(Phase_Data_t *phase, uint32_t now_time)
{
    phase->p_cur = MA_Update(&phase->filter, *(phase->adc_raw_ptr));

    switch(phase->mode_det)
    {
      case WAIT_NEG:
        if (phase->p_cur < phase->zero_val - 100)
        {
          if(phase->phase_detected == true){
            phase->mode_det = WAIT_ZC_UP;
          }else{
            phase->mode_det = WAIT_POS;
          }
        }
        break;
      case WAIT_POS:
        if (phase->p_cur > phase->zero_val + 100)
        {
          if(++phase->cnt_detect == TIME_DET_PHASE){
            phase->phase_detected = true;
						mode_buzzer_status = BUZZER_SET_TRIGGER_PIP;   // only on MASTER
          }
          phase->mode_det = WAIT_NEG;
        }
        break;
      case WAIT_ZC_UP: 
			{
        uint32_t itv_lZC = now_time - phase->last_zc;

        /* Rising Zero-Cross */
        if (phase->p_prev <= phase->zero_val && phase->p_cur>phase->zero_val)
        {
            /* First edge after startup or loss-grid */
            if (phase->last_zc == 0U)
            {
                phase->last_zc = now_time;
            }
            else
            {
                while(itv_lZC > RANGE_GRID_H){
                  itv_lZC -= CYCLE_GRID;
                }
                if ((itv_lZC >= RANGE_GRID_L) && (itv_lZC <= RANGE_GRID_H))
                {
                  phase->now_zc       = now_time;
                  phase->interval_zc  = itv_lZC;
                    
                  phase->has_new_edge = true;
                  phase->last_zc = now_time;
                  phase->cnt_det_loss_grid = 0;
                }			
            }
            phase->mode_det = WAIT_NEG;
        }
        phase->p_prev = phase->p_cur;
        break;
			}
      case LOSS_GRID:
        phase->phase_detected = false;
        phase->cnt_detect  = 0;
        phase->last_zc     = 0;
        phase->now_zc = 0;
        phase->mode_det = WAIT_NEG;
        break;
    }
    
    if(phase->phase_detected){
      if(++phase->cnt_det_loss_grid == LOSS_GRID_TIMEOUT) phase->mode_det = LOSS_GRID;
    }   
}

void HAL_TIM_PeriodElapsedCallback(TIM_HandleTypeDef *htim)
{
  if (htim->Instance == TIM1) //50us
  {
    cnt_send_cmd++;
    cnt_handle_led++;
    cnt_handle_buzzer++;

		if(++flag_cnt_50us >= 2)    //100us
    {
      uint32_t now_time = GetTimeUs();
      flag_cnt_50us = 0;
			cnt_det_loss_grid++;

      Process_Phase_ZC(&phaseA, now_time);
      Process_Phase_ZC(&phaseB, now_time);
      Process_Phase_ZC(&phaseC, now_time);

      // Nếu Pha A có cạnh lên và đang đợi kiểm tra đồng bộ ZC
      if (phaseA.has_new_edge) 
      {
        phaseA.has_new_edge = false; // Xóa cờ ngay
        if (flag_enable_zc) 
        {
          flag_enable_zc = false;
          if (phaseA.phase_detected) 
          {
            delta_pAB = 1;
            delta_pAC = 2;
            if(phaseB.phase_detected && phaseC.phase_detected)
            {
              delta_pAB = phaseA.now_zc - phaseB.last_zc;
              delta_pAC = phaseA.now_zc - phaseC.last_zc;
            }
            flag_send_lora = true;
          }
        }
      }
      phaseB.has_new_edge = false;
      phaseC.has_new_edge = false;
    }
  }

  if(htim->Instance == TIM3)
  {
    ovf_tim3++;
  }
}


void HAL_GPIO_EXTI_Callback(uint16_t GPIO_Pin)
	{
		/* Prevent unused argument(s) compilation warning */
		UNUSED(GPIO_Pin);

//		if(GPIO_Pin == vLoRa.DIO0_pin)
//		{
//			num_RX_irq_LoRa++;
//			flag_Lora_Rx = 1;	 
//		}	
	}


/* USER CODE END 0 */

/**
  * @brief  The application entry point.
  * @retval int
  */
int main(void)
{

  /* MCU Configuration--------------------------------------------------------*/

  /* Reset of all peripherals, Initializes the Flash interface and the Systick. */
  HAL_Init();

  /* Configure the system clock */
  SystemClock_Config();

  /* Initialize all configured peripherals */
  MX_GPIO_Init();
  MX_DMA_Init();
  MX_TIM1_Init();
  MX_USART1_UART_Init();
  MX_ADC1_Init();
  MX_SPI1_Init();
  MX_TIM3_Init();
  MX_TIM2_Init();
  /* USER CODE BEGIN 2 */
  ON_LED_DEBUG();
  ON_LED_STATUS_1();
	
	ON_LED_PA();
  ON_LED_PB();
  ON_LED_PC();

	Lora_Init(&vLoRa, &hspi1, 912);
	LoRa_reset(&vLoRa);
	config_lora = LoRa_Config(&vLoRa);
	
	while(config_lora!=0x00C8){
		ON_LED_DEBUG(); 
    Lora_Init(&vLoRa, &hspi1, 912);
	  LoRa_reset(&vLoRa);
    config_lora = LoRa_Config(&vLoRa);
		OFF_LED_DEBUG();
		HAL_Delay(15);
	}
  LoRa_startReceiving(&vLoRa);
  // Config Lora ok
  OFF_LED_DEBUG();
  OFF_LED_STATUS();

  HAL_ADC_Start_DMA(&hadc1, (uint32_t*)&adc_raw, 3);

  Phase_init(&phaseA, &adc_raw[0], ZERO_PA);
  Phase_init(&phaseB, &adc_raw[1], ZERO_PB);
  Phase_init(&phaseC, &adc_raw[2], ZERO_PC);

  BUZZER_ON(); HAL_Delay(30);
	BUZZER_OFF(); HAL_Delay(100);
  OFF_LED_PA();
	BUZZER_ON(); HAL_Delay(30);
	BUZZER_OFF(); HAL_Delay(100);
  OFF_LED_PB();
	BUZZER_ON(); HAL_Delay(30);
	BUZZER_OFF(); HAL_Delay(100);
  OFF_LED_PC();

 HAL_TIM_Base_Start_IT(&htim1);
  HAL_TIM_Base_Start_IT(&htim3);

  /* USER CODE END 2 */

  /* Infinite loop */
  /* USER CODE BEGIN WHILE */
  while (1)
  {
    /* USER CODE END WHILE */

    /* USER CODE BEGIN 3 */
		tick_master++;
		
    // Set Flag send command to LoRa module
		if(cnt_send_cmd >= cycle_send && phaseA.phase_detected){
			cnt_send_cmd = 0;
			HAL_GPIO_TogglePin(LED_DEBUG_ON_BOARD_GPIO_Port, LED_DEBUG_ON_BOARD_Pin);
      flag_enable_zc = true;
    }

    // Send Lora data ------------------------------------------------------------------
    
		
		Handle_LoRa_TX();

    // Get offset for ADC measurement
    Get_Offset();

    // Handle LED status
    Handle_LED();

    // Handle Buzzer
    Handle_Buzzer();
		
  }
  /* USER CODE END 3 */
}

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
/* USER CODE BEGIN 4 */


void Get_Offset(void)
{  
  if(flag_get_zero == 0) return;
	flag_get_zero = 0;
  
  uint32_t sumA = 0;
  uint32_t sumB = 0;
  uint32_t sumC = 0;

  for(int i=0; i<1000; i++)
  {
    sumA += adc_raw[0];
    sumB += adc_raw[1];
    sumC += adc_raw[2];
    HAL_Delay(1);
  }

  offset_pA = sumA / 1000;
  offset_pB = sumB / 1000;
  offset_pC = sumC / 1000;
	
	mode_buzzer_status = BUZZER_ON;
}

void OFF_LED_STATUS(void)
{
  HAL_GPIO_WritePin(LED_STATUS_MASTER_1_GPIO_Port, LED_STATUS_MASTER_1_Pin, GPIO_PIN_RESET);
  HAL_GPIO_WritePin(LED_STATUS_MASTER_2_GPIO_Port, LED_STATUS_MASTER_2_Pin, GPIO_PIN_RESET);
}

void ON_LED_STATUS_1(void)
{
  HAL_GPIO_WritePin(LED_STATUS_MASTER_1_GPIO_Port, LED_STATUS_MASTER_1_Pin, GPIO_PIN_SET);
  HAL_GPIO_WritePin(LED_STATUS_MASTER_2_GPIO_Port, LED_STATUS_MASTER_2_Pin, GPIO_PIN_RESET);
}

void ON_LED_STATUS_2(void)
{
  HAL_GPIO_WritePin(LED_STATUS_MASTER_1_GPIO_Port, LED_STATUS_MASTER_1_Pin, GPIO_PIN_RESET);
  HAL_GPIO_WritePin(LED_STATUS_MASTER_2_GPIO_Port, LED_STATUS_MASTER_2_Pin, GPIO_PIN_SET);
}

void Handle_LED(void)
{
  if(phaseA.phase_detected){ON_LED_PA();}
	else{OFF_LED_PA();}	
	
	if(phaseB.phase_detected){ON_LED_PB();}
	else{OFF_LED_PB();}	
	
	if(phaseC.phase_detected){ON_LED_PC();}
	else{OFF_LED_PC();}	

  switch(mode_led_status)
  {
    case MODE_OFF:
      OFF_LED_STATUS();
      break;
    case MODE_STS_1:
      ON_LED_STATUS_1();
      break;
    case MODE_STS_2:
      ON_LED_STATUS_2();
      break;
    case MODE_SET_FLASH_1:
      cnt_handle_led = 0;
      ON_LED_STATUS_1();
      mode_led_status = MODE_FLASH_1;
      break;
    case MODE_FLASH_1:
      if(cnt_handle_led >= 600){			// 30ms
        cnt_handle_led = 0;
        mode_led_status = MODE_OFF;      
      }
      break;
    case MODE_SET_FLASH_2:
      cnt_handle_led = 0;
      ON_LED_STATUS_2();
      mode_led_status = MODE_FLASH_2;
      break;
    case MODE_FLASH_2:
      if(cnt_handle_led >= 600){			// 30ms
        cnt_handle_led = 0;
        mode_led_status = MODE_OFF;      
      }
      break;
    default:
      break;     
  }
}

void Handle_Buzzer(void)
{
  switch(mode_buzzer_status)
  {
    case BUZZER_OFF:
      BUZZER_OFF();
      break;
    case BUZZER_ON:
			BUZZER_ON();
      break;
    case BUZZER_SET_TRIGGER_PIP:
      // Initialize pip mode
      cnt_handle_buzzer = 0;
			BUZZER_ON();
      mode_buzzer_status = BUZZER_TRIGGER_PIP;
      break;
    case BUZZER_TRIGGER_PIP:
      if(cnt_handle_buzzer >= 3000)					// 3000*0.00005
      {
        mode_buzzer_status = BUZZER_OFF;
      }
      break;
    default:
      break;
  }
}

void Handle_LoRa_TX(void)
{
	if(!flag_send_lora) return;
	flag_send_lora = false;

	TX_Lora_buff[0] = 0xAA;
	TX_Lora_buff[1] = 0;
	TX_Lora_buff[2] = (delta_pAB%CYCLE_GRID)/100;
	TX_Lora_buff[3] = (delta_pAC%CYCLE_GRID)/100;
	TX_Lora_buff[4] = TX_Lora_buff[0] + TX_Lora_buff[1] + TX_Lora_buff[2] + TX_Lora_buff[3];
								
	send_ok = LoRa_transmit(&vLoRa, (uint8_t*)TX_Lora_buff, 5, 10000000);

	if(send_ok == 1){
		HAL_GPIO_TogglePin(LED_DEBUG_ON_BOARD_GPIO_Port, LED_DEBUG_ON_BOARD_Pin);
		cnt_sendOK++;
		mode_led_status = MODE_SET_FLASH_1;
		//mode_buzzer_status = BUZZER_SET_TRIGGER_PIP;
	}
}

void MA_Init(MA_Filter_t *f, uint16_t init_value)
{
    f->sum = 0;
    f->index = 0;

    for(int i=0; i<MA_SIZE_PHASE_ZC; i++)
    {
        f->buf[i] = init_value;
        f->sum += init_value;
    }
}

uint16_t MA_Update(MA_Filter_t *f, uint16_t sample)
{
    f->sum -= f->buf[f->index];
    f->buf[f->index] = sample;
    f->sum += sample;
    f->index++;
    if(f->index >= MA_SIZE_PHASE_ZC)
        f->index = 0;
    return f->sum / MA_SIZE_PHASE_ZC;
}

/* USER CODE END 4 */
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
