GitHubLHAn/Phase_Detection_Project/Master_Sender_v1/Core/Inc/main.h

#define LED_DEBUG_ON_BOARD_Pin GPIO_PIN_13
#define LED_DEBUG_ON_BOARD_GPIO_Port GPIOC
#define ADC1_IN0_PA_Pin GPIO_PIN_0
#define ADC1_IN0_PA_GPIO_Port GPIOA
#define ADC1_IN1_PB_Pin GPIO_PIN_1
#define ADC1_IN1_PB_GPIO_Port GPIOA
#define ADC1_IN2_PC_Pin GPIO_PIN_2
#define ADC1_IN2_PC_GPIO_Port GPIOA
#define NSS_Pin GPIO_PIN_4
#define NSS_GPIO_Port GPIOA
#define RF_RESET_Pin GPIO_PIN_0
#define RF_RESET_GPIO_Port GPIOB
#define DIO0_Pin GPIO_PIN_1
#define DIO0_GPIO_Port GPIOB
#define DIO0_EXTI_IRQn EXTI1_IRQn
#define DETECT_ZC_PC_Pin GPIO_PIN_10
#define DETECT_ZC_PC_GPIO_Port GPIOB
#define GET_ZERO_Pin GPIO_PIN_15
#define GET_ZERO_GPIO_Port GPIOB
#define GEN_TRIGGER_Pin GPIO_PIN_8
#define GEN_TRIGGER_GPIO_Port GPIOA
#define UART_TX_Spare_Pin GPIO_PIN_9
#define UART_TX_Spare_GPIO_Port GPIOA
#define UART_RX_Spare_Pin GPIO_PIN_10
#define UART_RX_Spare_GPIO_Port GPIOA
#define MCU_BUZZER_Pin GPIO_PIN_11
#define MCU_BUZZER_GPIO_Port GPIOA
#define DETECT_ZC_PA_Pin GPIO_PIN_15
#define DETECT_ZC_PA_GPIO_Port GPIOA
#define DETECT_ZC_PB_Pin GPIO_PIN_3
#define DETECT_ZC_PB_GPIO_Port GPIOB
#define LED_PA_Pin GPIO_PIN_5
#define LED_PA_GPIO_Port GPIOB
#define LED_PB_Pin GPIO_PIN_6
#define LED_PB_GPIO_Port GPIOB
#define LED_PC_Pin GPIO_PIN_7
#define LED_PC_GPIO_Port GPIOB
#define LED_STATUS_MASTER_2_Pin GPIO_PIN_8
#define LED_STATUS_MASTER_2_GPIO_Port GPIOB
#define LED_STATUS_MASTER_1_Pin GPIO_PIN_9
#define LED_STATUS_MASTER_1_GPIO_Port GPIOB
