GitHubLHAn/Phase_Detection_Project/(commit log)

2026-07-06 Initial v1 - Edit follow schematic
2026-07-09 Edit master again, Edit slave, but wrong Sl
    [main.c, main_last_ver.c]
2026-07-14 Add file 3D box - ver 14.7.26
    [Cover pin.stl, Cover pin_SLA_Màu Xanh Cô Ban_SL01.stp, Hộp Master.stl, Hộp Master_SLA_Màu xanh Cô ban_SL01.stp, Hộp Slave.stl, Hộp Slave_SLA_Màu Xanh Cô Ban_SL01.stp, Master.dwg, Nắp Master.stl]
